Jenan-Ahmad/HGP/Graduation_Project_ASPS.pptx

Automated Sample Preparation System

Supervisor:
Dr. Aladdin Masri

Students:
Jenan Abualrub
Yaqout Salameh

## Outline

- Introduction
- Building process
- Mechanism of action
- Problems and constraints
- Live demo
- Notes & questions

## Introduction

- What does the study conducted in 2020 state?
- Automated Sample Preparation System (ASPS) will solve those problems!
- Improving reliability, safety, performance, and accuracy.
- Facilitating the process through a mobile application.

Notes: A study conducted in 2020 states that (61.9 - 68.2%) of the errors associated with laboratory tests occur within the pre-analytical phase of the test.

## Building process

- Components & hardware structure.
- Needle & syringe movement.
- Mobile application.
- MQTT protocol.
- Sensing circuit.

## Sensing circuit

Circuit diagram:

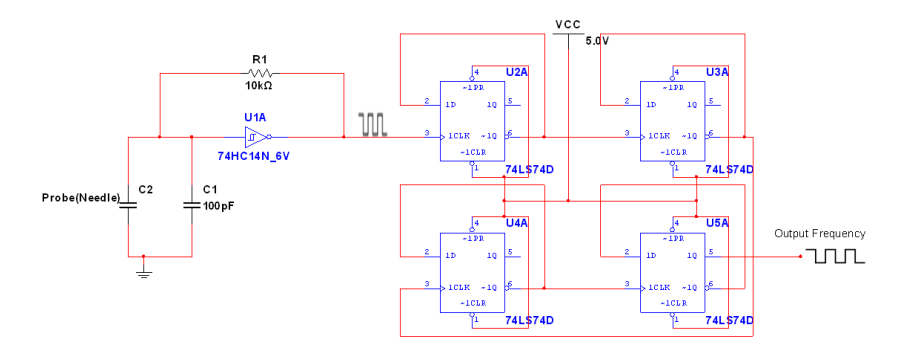
[picture p1: figure]

## Mechanism of action

System states:
- Initialization
- Cleaning
- Substance selection

## Problems and constraints

- High frequencies in the sensing part and using a frequency divider circuit.
- Building the wooden parts and designing them.
- Special care is needed for the reagents.

## Slide 8

Live demo ...

## Slide 9

Discussion

## Slide 10

Thank you!
