Jenan-Ahmad/HGP/ASPS_3D.stl

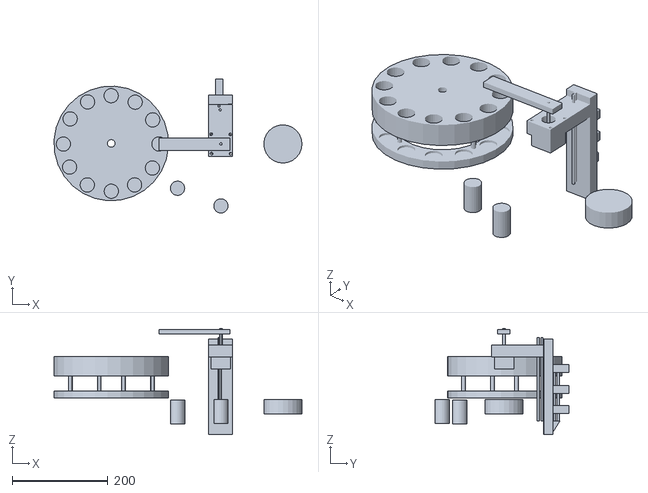
[picture p26: CAD file, 2023-08-14]
ASPS_3D.stl
518.9 x 280.7 x 222.6
